SerPanRC/multi_modul_arduino/PICT0221.JPG

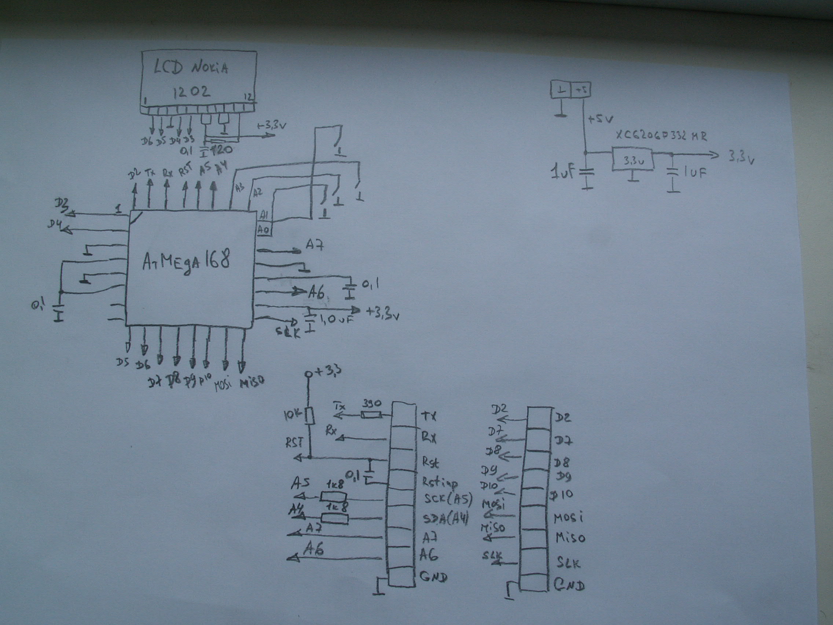
PICT0221.JPG
