SerPanRC/multi_modul_arduino/PICT0220.JPG

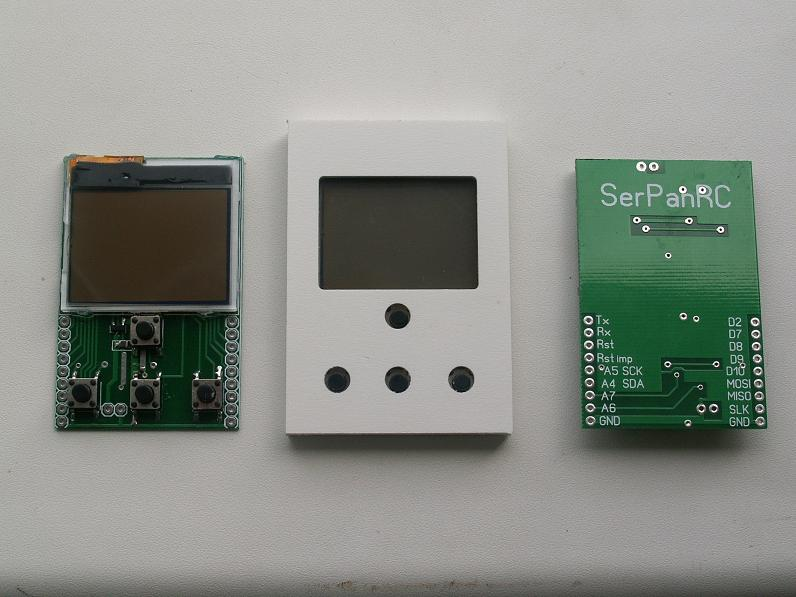
PICT0220.JPG
