SerPanRC/multi_modul_arduino/receiver_1_2Ghz/scheme1_2Ghz.JPG

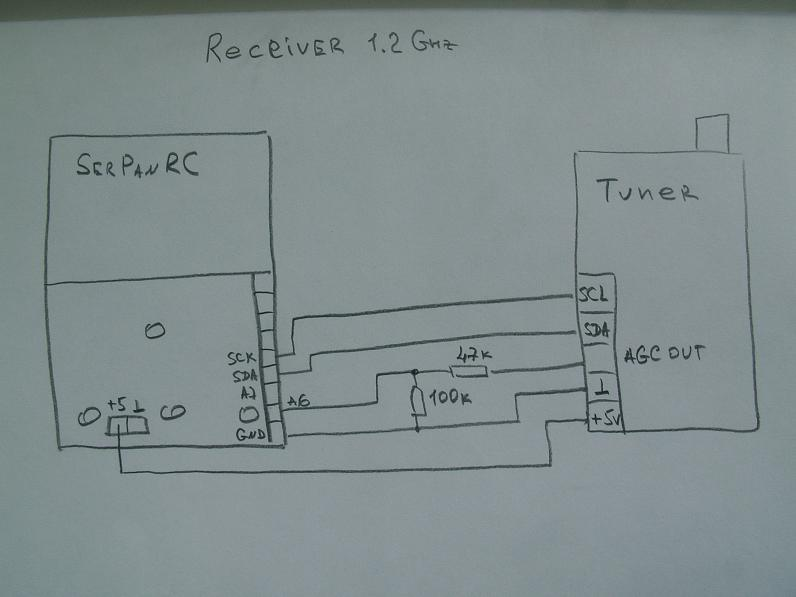
receiver_1_2Ghz/scheme1_2Ghz.JPG
