SerPanRC/multi_modul_arduino/(list of files, drawings)

Other design files:
SerPanRC_univ.lay
