SerPanRC/multi_modul_arduino/(threads)

Thread 1 (2024-02-01):

[q] подходящие тюнеры 1.2

whoim2, 2024-02-01:
Добрый день! Немного каша в голове после прочтения темы на rcgroups, поэтому проще спросить)
Подойдут ли тюнеры TA8812F+TA1322FN и/или TA8804F+TA1322FN?
Вообще, TA1322FN это замена SP5055 или они там обе присутствуют?
Или же надо искать только DA8012+SP5055?
Спасибо.

whoim2, 2024-03-03:
Ответ: TA8804F+TA1322FN подходит точно

Closed 2024-03-03.
