SerPanRC/multi_modul_arduino/(commit log)

2013-07-17 Добавил файл печатной платы
    [SerPanRC_univ.lay]
2013-07-17 Добавил схему универсального модуля
2013-07-17 Добавил фото модуля с фальш-корпусом
2013-07-17 Исправленная схема ( добавлены резисторы в шину I2C
2013-07-20 Добавил файлы описаний на тюнер и чипы в тюнерах
2013-07-20 Добовил информацию
2013-07-20 Добавил схему подключения модуля к тюнеру ресивера
2013-07-20 Добавлена информация для работы ардуино с контроллером, работающим от внутреннего генератора 8 мгц.
2013-07-20 Добавил файл для прошивки и описание для версии 1.0
2013-07-22 Добавил пример файла boards.txt
2013-07-23 Внес изменения.
2013-08-18 Добавлен режим переключения в соответствии с общепринятой сеткой частот. Расширен диапазон частот, игнорируемый при сканировании, для невозможности захвата частоты сотовой связи.
2013-08-18 Версия для тюнеров с инверсным выходом RSSI, выполненных на TDA8012 - REC_1_2_ser_v1_1_invert.ino
2013-08-19 Добавлен проект приемника на диапазон 5,8Ггц.
2013-08-19 Добавил компилированный файл- hex.
2014-04-28 Устранил ошибку в режиме сканирования.
